gilberto-coelho/3D-Printed-Orbitrap-XYZ-Positioning-Platform/STL-files/Linear-stage/V-slot carriage holder.stl

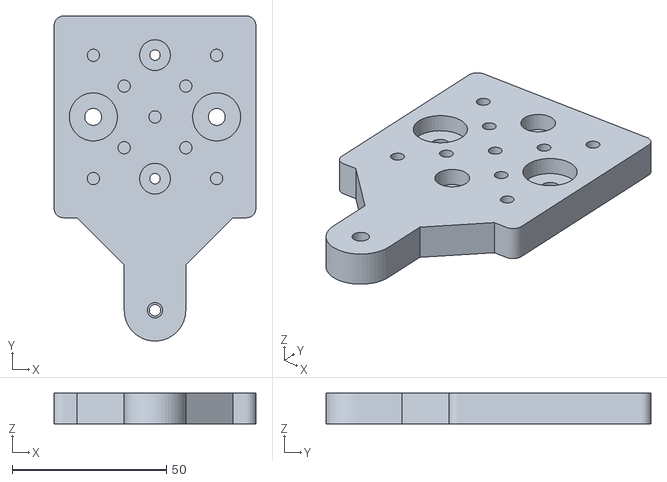
[picture p1: CAD file, 2026-10-13]
STL-files/Linear-stage/V-slot carriage holder.stl
65.5 x 105.5 x 10.0
