gilberto-coelho/3D-Printed-Orbitrap-XYZ-Positioning-Platform/STL-files/Orbitrap-holder/Orbitrap holder locker.stl

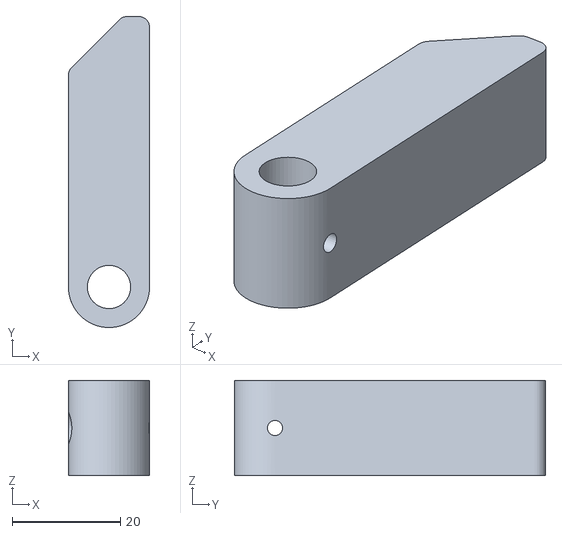
[picture p2: CAD file, 2026-10-13]
STL-files/Orbitrap-holder/Orbitrap holder locker.stl
15.0 x 57.5 x 17.6
