gilberto-coelho/3D-Printed-Orbitrap-XYZ-Positioning-Platform/STL-files/Linear-stage/90 degrees linear stage 1.stl

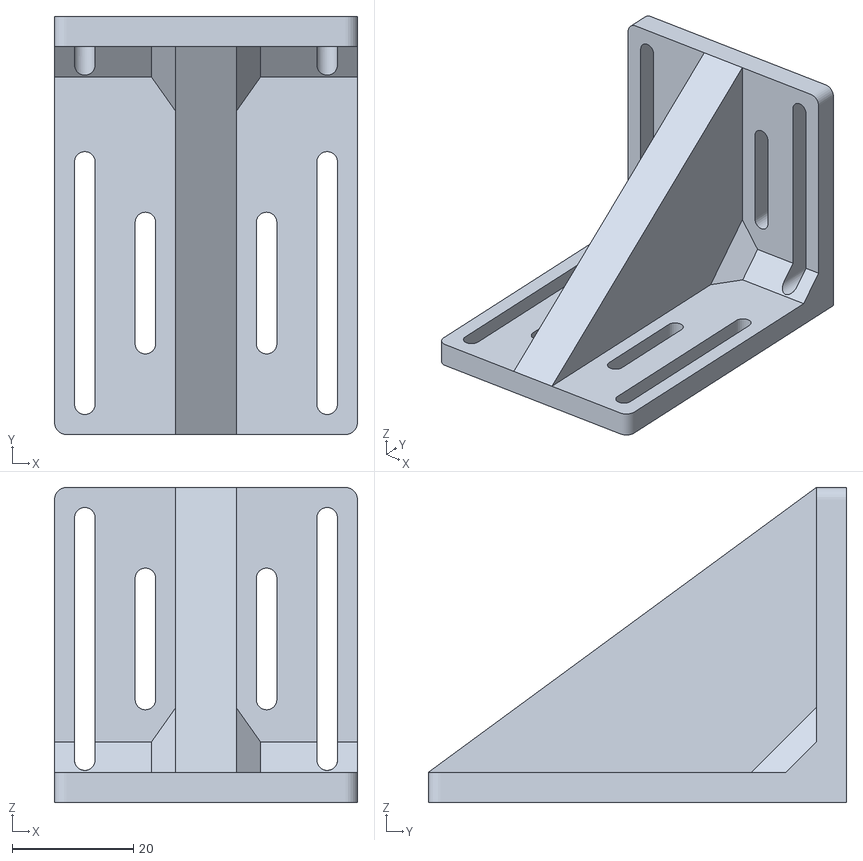
[picture p3: CAD file, 2026-10-13]
STL-files/Linear-stage/90 degrees linear stage 1.stl
50.0 x 69.0 x 52.0
