gilberto-coelho/3D-Printed-Orbitrap-XYZ-Positioning-Platform/STL-files/Linear-stage/Linear stage BOTTOM.stl

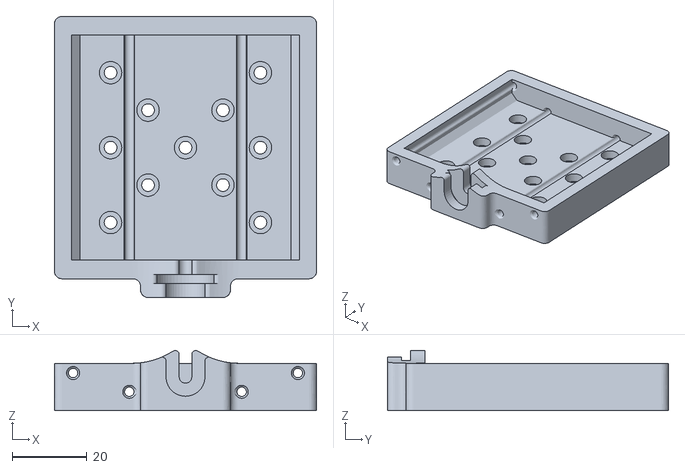
[picture p4: CAD file, 2026-10-13]
STL-files/Linear-stage/Linear stage BOTTOM.stl
70.0 x 75.0 x 16.0
