gilberto-coelho/3D-Printed-Orbitrap-XYZ-Positioning-Platform/STL-files/Orbitrap-holder/Obitrap holder 1.stl

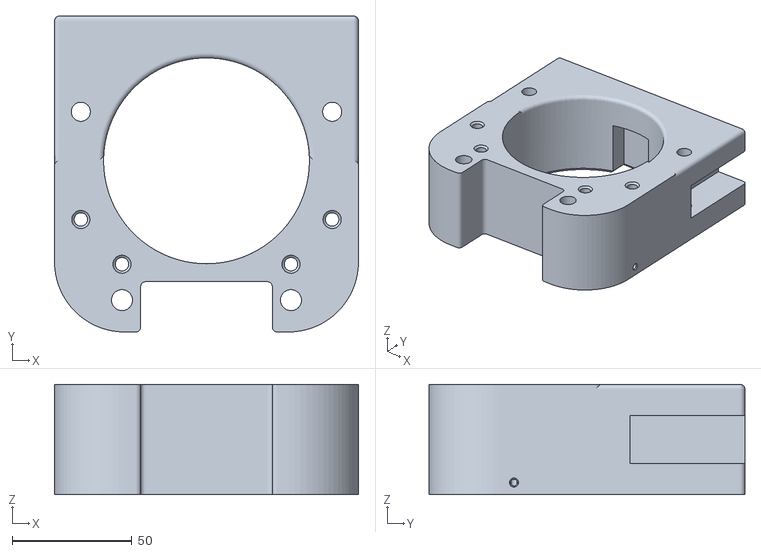
[picture p5: CAD file, 2026-10-13]
STL-files/Orbitrap-holder/Obitrap holder 1.stl
127.0 x 132.0 x 46.0
