gilberto-coelho/3D-Printed-Orbitrap-XYZ-Positioning-Platform/STL-files/Linear-stage/Linear stage TOP.stl

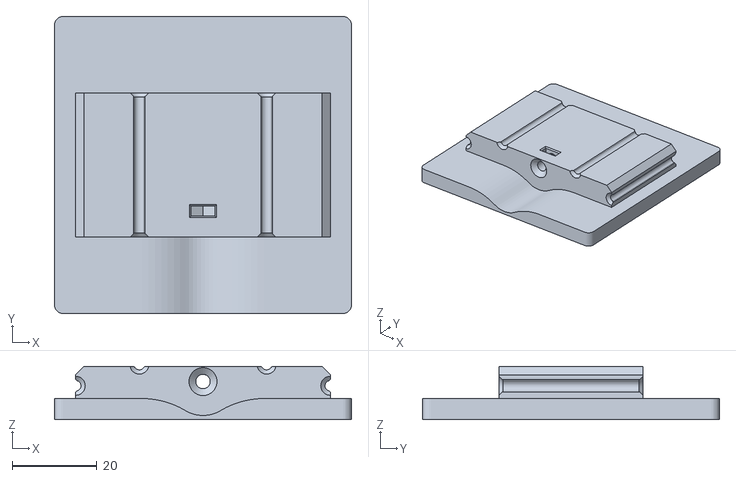
[picture p6: CAD file, 2026-10-13]
STL-files/Linear-stage/Linear stage TOP.stl
70.0 x 70.0 x 12.6
