gilberto-coelho/3D-Printed-Orbitrap-XYZ-Positioning-Platform/STL-files/Orbitrap-holder/Obitrap holder 2.stl

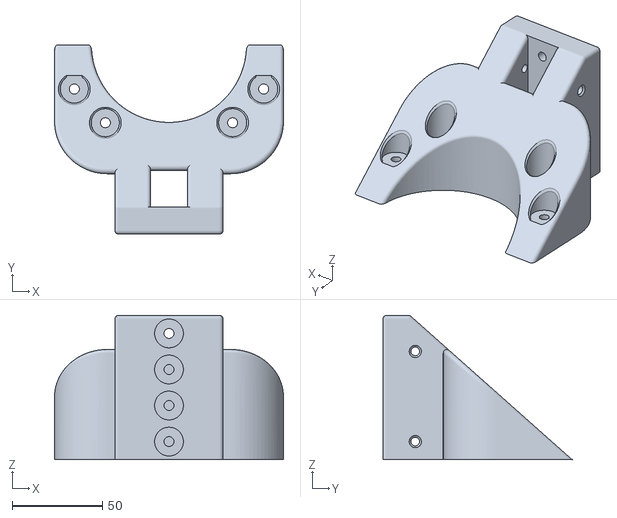
[picture p7: CAD file, 2026-10-13]
STL-files/Orbitrap-holder/Obitrap holder 2.stl
127.0 x 105.0 x 80.0
