gilberto-coelho/3D-Printed-Orbitrap-XYZ-Positioning-Platform/STL-files/Linear-stage/90 degrees linear stage - SHORT.stl

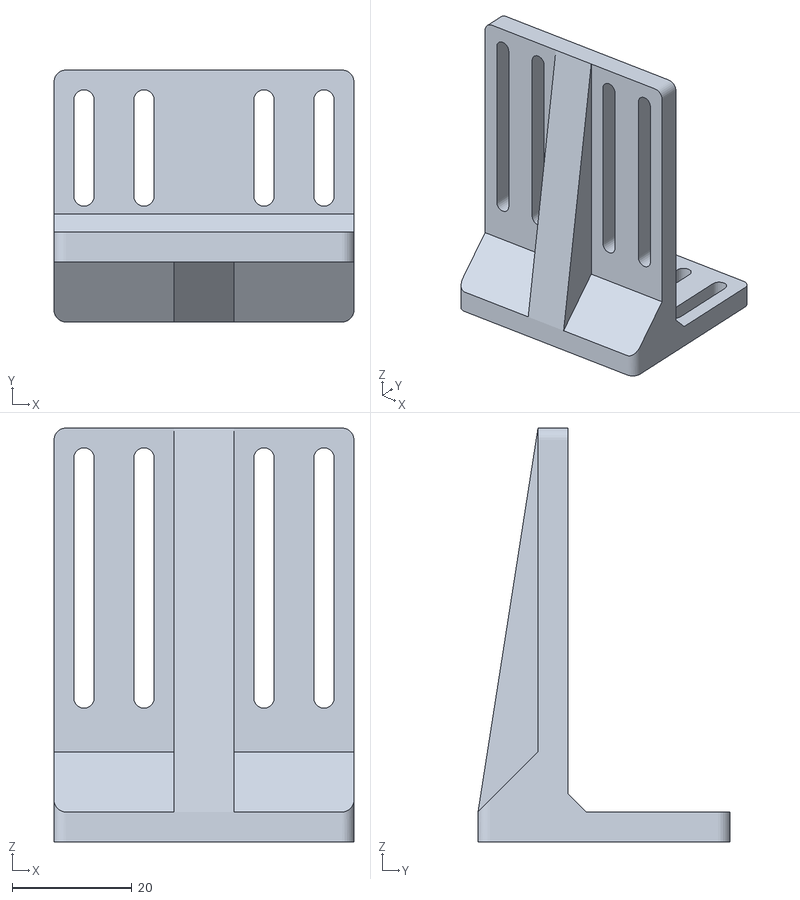
[picture p8: CAD file, 2026-10-13]
STL-files/Linear-stage/90 degrees linear stage - SHORT.stl
50.0 x 42.0 x 69.0
