gilberto-coelho/3D-Printed-Orbitrap-XYZ-Positioning-Platform/STL-files/Orbitrap-holder/Orbitrap holder washer.stl

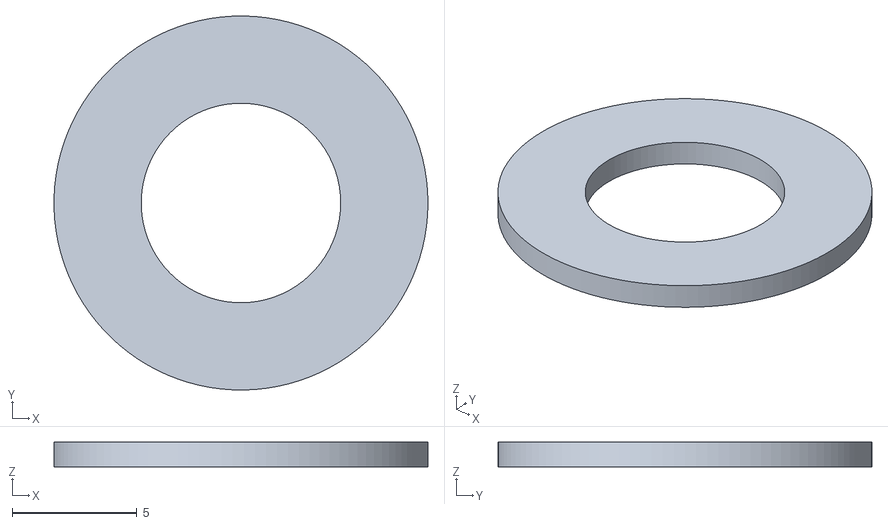
[picture p9: CAD file, 2026-10-13]
STL-files/Orbitrap-holder/Orbitrap holder washer.stl
15.0 x 15.0 x 1.00
