gilberto-coelho/3D-Printed-Orbitrap-XYZ-Positioning-Platform/STL-files/Linear-stage/Screw holder.stl

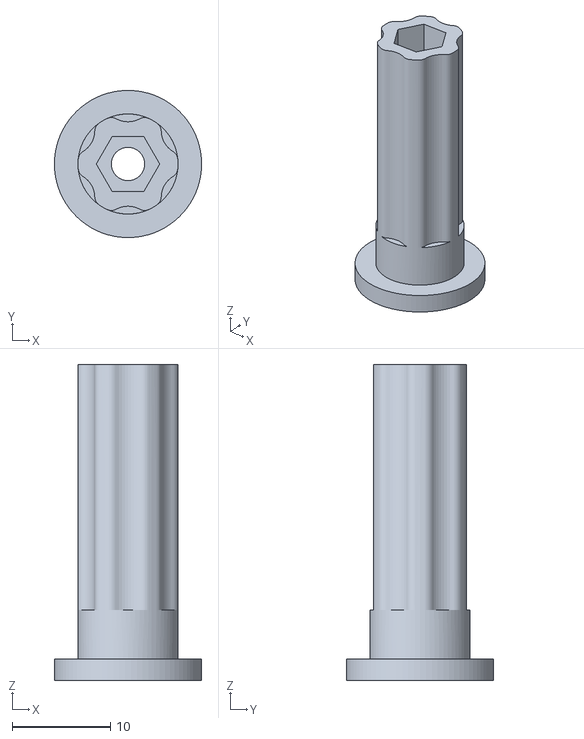
[picture p10: CAD file, 2026-10-13]
STL-files/Linear-stage/Screw holder.stl
15.0 x 15.0 x 32.2
