gilberto-coelho/3D-Printed-Orbitrap-XYZ-Positioning-Platform/STL-files/Linear-stage/Screw locker.stl

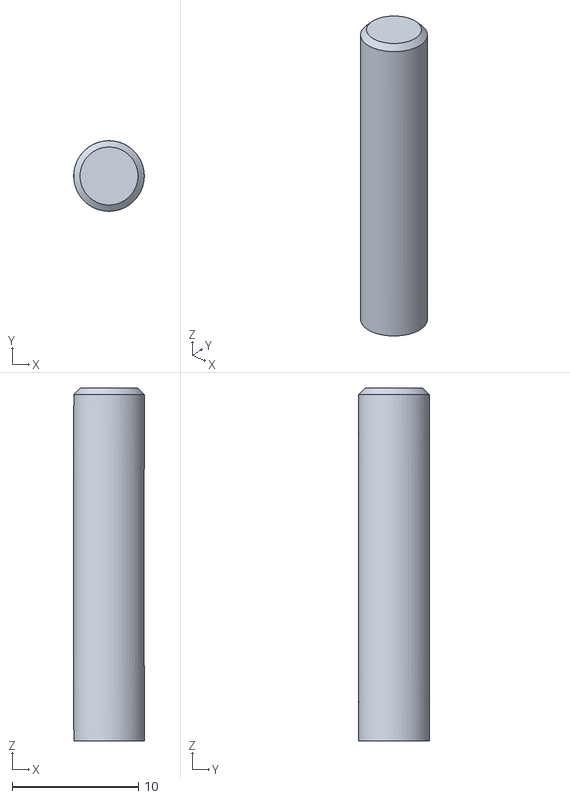
[picture p11: CAD file, 2026-10-13]
STL-files/Linear-stage/Screw locker.stl
5.60 x 5.60 x 28.0
