gilberto-coelho/3D-Printed-Orbitrap-XYZ-Positioning-Platform/(commit log)

2026-10-13 Add README for linear stage STL files
2026-10-13 Add README for Orbitrap holder STL files
2026-10-13 Add printable position scale instructions
    Added instructions for a printable position scale to the README.
